Scott216/Hockey-Robot/Inverse Kinematics.xlsx

Sheet: Inverese Kinematics Calc
http://www.oliverjenkins.com/blog/2012/9/inverse-kinematics-and-robot-arms
http://www.learnaboutrobots.com/inverseKinematics.htm
https://www.circuitsathome.com/mcu/robotic-arm-inverse-kinematics-on-arduino
Github IK Discussion (https://github.com/phenoptix/MeArm/issues/3)
θ1 = ATan(y / x) + ACos( (L12 - L22 + X2 + Y2) / (2 * L1 * B) )
θ2 = π - ACos ( (B2 - L12 - L22) / (2 * L1 * L2) )
L1 | L2 | X | Y | B | θ1 | θ2
9.0 | 7.0 | 7.0 | 9.0 | 11.4 | 90.0 | 90.0
9.0 | 7.0 | 16.0 | 0.0 | 16.0 | 0.0 | 0.0
9.0 | 7.0 | 11.3 | 11.3 | 16.0 | 45.0 | 0.01527808827
140.0 | 153.0 | 242.0 | 150.0 | 284.7 | 46.1 | 27.3
Sain Smart 4dof Arm (http://www.sainsmart.com/diy-4-axis-servos-control-palletizing-robot-arm-model-for-arduino-uno-mega2560.html)
Z should always be on hockey table.
L1 | L2 | Y | Z | B | θ1 | θ2 | Chart Data
140.0 | 153.0 | 250.0 | 10.0 | 250.2 | 35.2 | 117.2 | Y | Z
 |  |  |  |  |  |  | 0.0 | 0.0
 |  |  |  |  |  |  | 114.4 | 80.8
 |  |  |  |  |  |  | 250.0 | 10.0
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
