Scott216/Hockey-Robot/Arm Angles.jpg

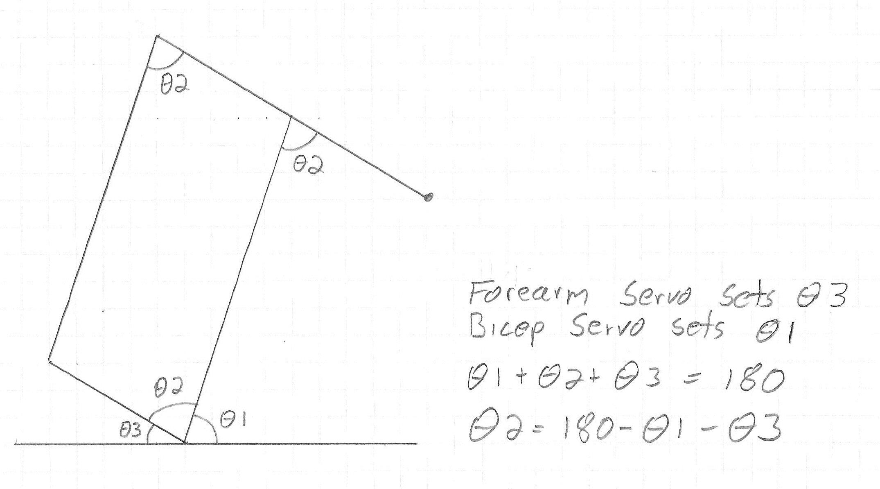
Arm Angles.jpg
