Scott216/Hockey-Robot/Design Files/Cutlist.png

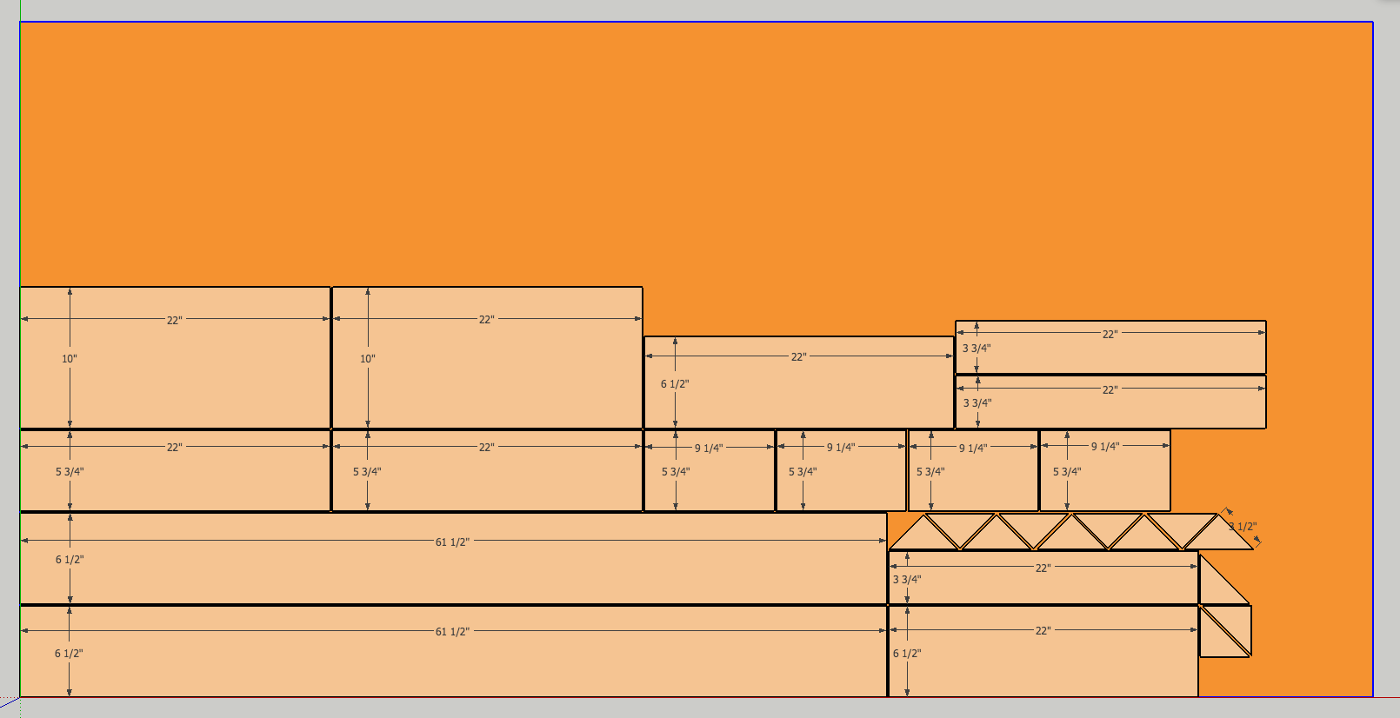
Design Files/Cutlist.png
