Scott216/Hockey-Robot/Design Files/Hockey Table Schematic.png

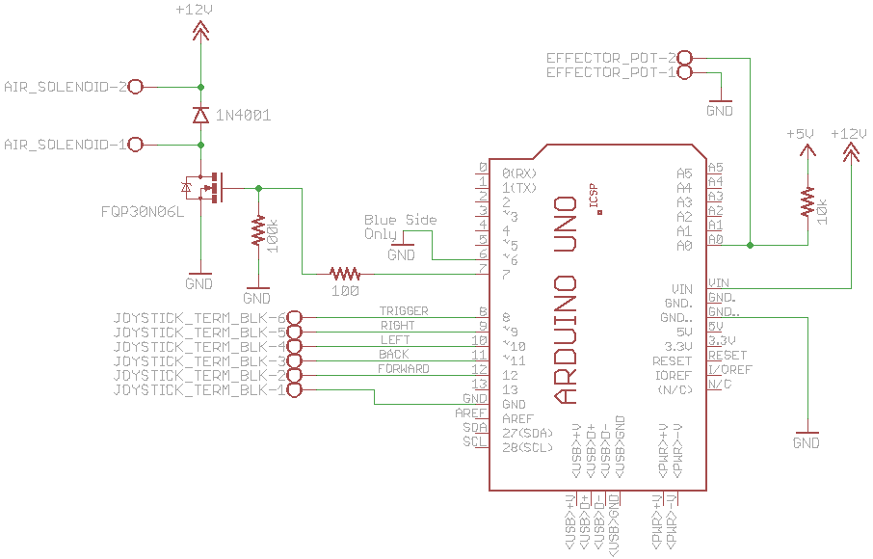
Design Files/Hockey Table Schematic.png
