Scott216/Hockey-Robot/Design Files/BoM.xlsx

Qty | Description | Source | Part Num | Price (each) | Comments
1 | 3/4" Sheet plywood, Grade A | Lumber Yard |  | $60.00
1 | 1/4" Sheet tempered Masonite | Lumber Yard |  | $22.00
2 | Arduino Uno R3 | Sparkfun | DEV-11021 | $25.00 | Can get clones a lot cheaper
2 | Servo board I2C | Adafruit | 1411 | $17.50
2 | Arcade Joystick | Sparkfun | COM-09136 | $20.00
2 | N-channel MOSFETs, FQP30N06L | Sparkfun | COM-10213 | $0.95 | Turns on air solenoid
2 | 100k 1/8 watt resistor | Digikey | CF18JT100KCT-ND | $0.10
2 | 100 ohm 1/8 watt restors | Digikey | CF18JT100RCT-ND | $0.10
2 | 1N4001 Diode | Digikey | 1N4001-TPMSCT-ND | $0.10
4 | 2-position terminal block | Digikey | A98333-ND | $0.87
2 | 4-position terminal block | Digikey | A98335-ND | $2.24
2 | DIN Plug | Digikey | CP-1030-ND | $1.66
2 | DIN Receptacle, panel mount | Digikey | CP-1230-ND | $2.31
2 | 10k Potientometer | Amazon | a13060500ux0042 | $0.65
2 | Knobs for Potientometer | Amazon | a13041000ux0023 | $0.52
10 | Terminal connectors | McMaster | 7243K112 | $0.43
2 | 4-axis Robotic Arms | SainSmart | 20-014-303 | $118.00 | SCARA style arm would be better
8 | Servo extension cables | Amazon |  | $1.00
2 | Air Soleniod valves, 12 volt | McMaster | 61975K41 | $29.40 | Can get cheaper on Ebay
1 | Air Regulator, 2-125 PSI | McMaster | 41735K11 | $30.25 | Can get cheaper on Amazon
1 | Mounting Bracket for Air regulator | McMaster | 41735K48 | $9.71
1 | Pressure Gauge 0-100 PSI | Ebay |  | $10.00
8 | 10-32 x 7/8" Socket Head Cap Screws | McMaster | 91251A346 | $0.12 | To mount joystick
8 | 10-32 Flange Nuts | McMaster | 94831A611 | $0.04 | To mount joystick
8 | 1/4-20 x 3" studs | McMaster | 91565A554 | $0.28 | Studs for joystick mount Can buy 3" bolts and cut of head.
8 | #6 x 1/2" pan head sheet metal screw | McMaster | 90190A148 | $0.03 | Mount robot arm
16 | #6 x 3/8" pan head sheet metal screws | McMaster | 90190A146 | $0.02
3 | Aluminum angle brackets | McMaster | 1556A24 | $0.43 | To hold joystick platform and power supply
6 | #10 x 3/8 pan head sheet metal screw | McMaster | 90190A240 | $0.06 | for angle bracket
4 | M4x5 machine screws | McMaster | 91239A136 | $0.12 | Mount air solenoid to bracket
1 | 1-1/4" aluminum angle | McMaster | 8982K11 | $3.90 | To hold air solenoid, need to cut
1 | Power supply, 190 watt | Compaq | 173828-001 | $20.00 | Need 5v and 12v. From a 1U server. Avail on ebay
1 | Computer power cord | Junk Drawer |  | $0.00 | For power supply
2 | 3D printed Arduino mounts |  |  | $1.78
2 | 3D printed joystick mounts |  |  | $13.62 | Use 50% infill so it's strong
2 | 3D printed ball scoops on effector |  |  | $0.77
6 | M3 Heat-set Threaded Inserts | McMaster | 94180A333 | $0.15 | Mount Arduino Uno, screw can only fit in 3 of the 4 holes
6 | M3 x 6 socket head cap screws | McMaster | 91290A111 | $0.08 | Mount Arduino Uno, screw can only fit in 3 of the 4 holes
4 | M3 x 8 Socket head cap screws | McMaster | 94500A222 | $0.06 | Mount DIN receptacle
4 | M3 Nuts | McMaster | 90592A009 | $0.01 | Mount DIN receptacle
1 | 1/8" Clear Acrylic | McMaster | 8589K42 | $9.82 | For Logo
1 | 1/8" Black Acrylic | McMaster | 8505K11 | $6.74 | For Lettering
2 | Brass Barbed Hose Fitting, Adapter for 1/8" Hose ID X 1/4" NPTF | McMaster | 5346K62 | $1.19
1 | Air hose quick disconnect coupling | McMaster | 6536K18 | $5.63
2 | 1/4" Push to connect x 1/4" Male NPT hose coupling, 90 degree | McMaster | 5779K152 | $3.42
1 | 1/4" Push to connect x 1/4" male NPT hose coupling | McMaster | 5779K109 | $3.08
1 | Push to connect Tee | McMaster | 5779K34 | $4.75
10 | 1/4" Tubing, push to connect | McMaster | 5180K71 | $0.10 | From regulator to solenoids
5 | 1/4" OD, 1/8" ID flexible tubing | McMaster | 51075K22 | $0.79 | Air line from effector to solenoid
2 | Hose Clamps | McMaster | 5388K14 | $0.59
12 | Small Ty-raps | McMaster | 7130K52 | $0.02
1 | Pack 3/8" x 2" wood dowel pegs | McMaster | 97195A434 | $4.67
4 | 1/4" Plastic Loop Clamps | McMaster | 8876T13 | $0.05 | Holding wiring and tubing
4 | 3/8" Plastic Loop Clamps | McMaster | 8876T22 | $0.06 | Holding wiring
2 | 22 AWG Solid wire, various colors | McMaster | 8073K62 | $0.10 | Wiring on Servo board
20 | 22 AWG Stranded wire, various colors | McMaster | 7587K52 | $0.11 | Wiring from joystick and potientometer to Arduino
10 | 3-conductor standed cable | McMaster | 6452T41 | $0.62 | For power to arduino
1 | 6- position Connector Barrier Block Strip | Digikey | A98507-ND | $2.85 | For power supply
1 | Heat shrink tubing | McMaster | 7856K63 | $0.80 | For DIN receptacle
6 | Spade terminals | McMaster | 69145K212 | $0.15 | Power supply to terminal connector
1 | Pack ping pong balls |  |  | $3.00
1 | Compressor |  |  | $60.00
 | Grand Total |  |  | $775.88
