Scott216/Hockey-Robot/Design Files/Uno Mount.stl

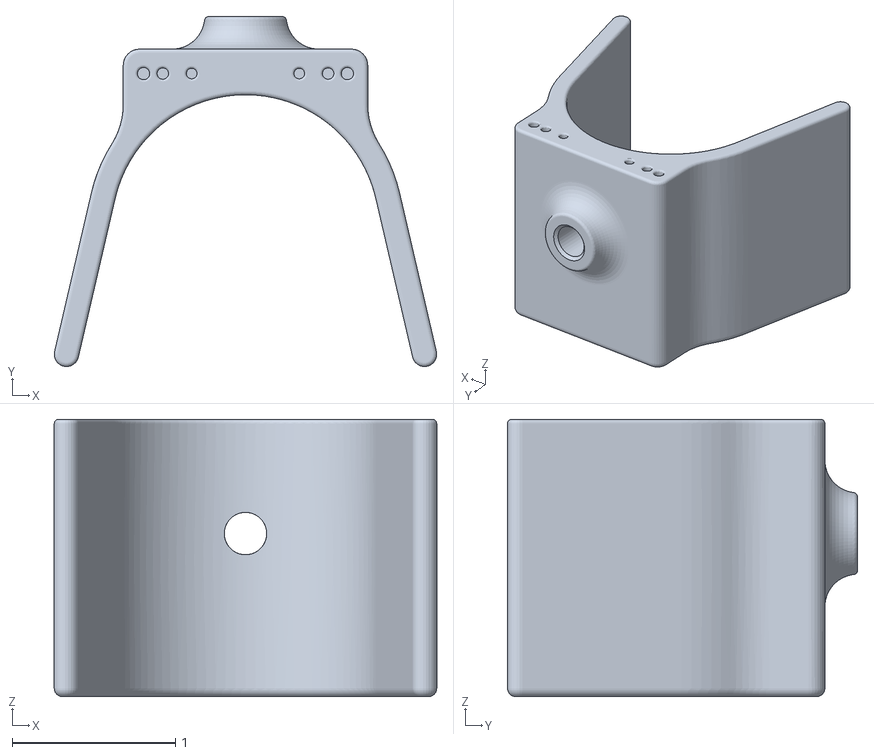
[picture p4: CAD file, 2015-10-01]
Design Files/Uno Mount.stl
2.35 x 2.15 x 1.70
