Scott216/Hockey-Robot/Design Files/Joystick Mount.stl

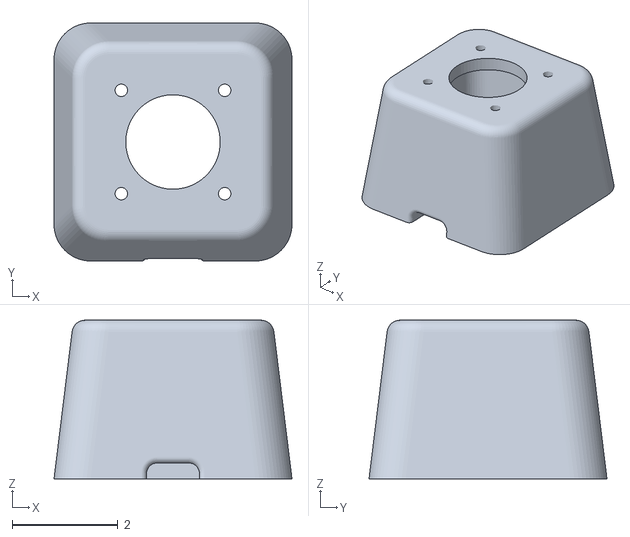
[picture p5: CAD file, 2015-10-01]
Design Files/Joystick Mount.stl
4.50 x 4.50 x 3.00
