Scott216/Hockey-Robot/(list of files, cad)

Other CAD files:
Design Files/Effectror.stl
Design Files/Hockey Table.f3d
Design Files/Plywood Cut List.skp
Design Files/Plywood Cut List~.skp
