Scott216/Hockey-Robot/Design Files/Hockey Table.sch

## EAGLE design Design Files/Hockey Table.sch (2015-10-01)

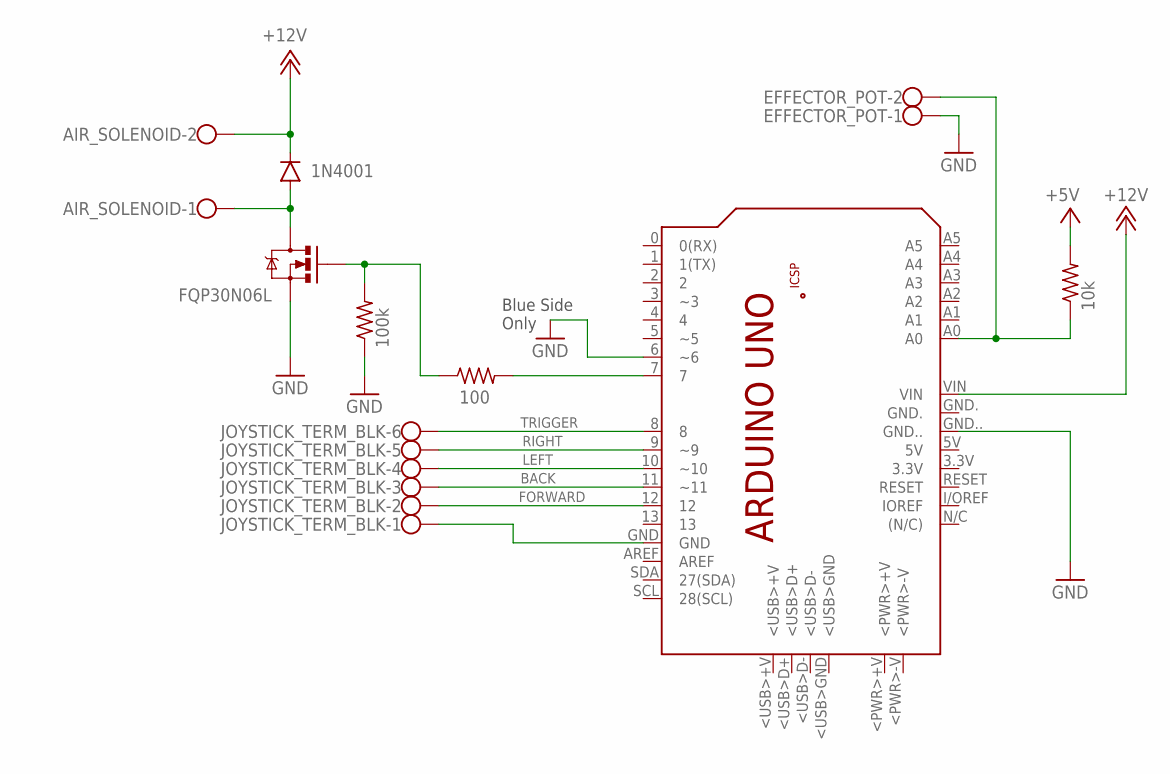
[picture p6: schematic Hockey Table.sch]

Parts:
AIR_SOLENOID: TERMBLK_SCREW_2RIGHT; TERMBLK_SCREW_2
D1: 1N4001; DIODE-1N4148
EFFECTOR_POT: TERMBLK_SCREW_2RIGHT; TERMBLK_SCREW_2
JOYSTICK_TERM_BLK: TERMBLK_SCREW_6RIGHT; TERMBLK_SCREW_6
PCB1: ARDUINO_UNO
Q1: FQP30N06L; TO220V
R1: 10k; 0207/10
R2: 100k; 0207/10
R3: 100; 0207/10

Connections:
+5V: R1.2
+12V: AIR_SOLENOID.2, D1.C, PCB1.VIN
BACK: JOYSTICK_TERM_BLK.3, PCB1.11 (~11)
FORWARD: JOYSTICK_TERM_BLK.2, PCB1.12
GND: EFFECTOR_POT.1, PCB1.6 (~6), PCB1.GND.., Q1.3 (S), R2.1
LEFT: JOYSTICK_TERM_BLK.4, PCB1.10 (~10)
unnamed: JOYSTICK_TERM_BLK.1, PCB1.GND
unnamed: EFFECTOR_POT.2, PCB1.A0, R1.1
unnamed: AIR_SOLENOID.1, D1.A, Q1.2 (D)
unnamed: Q1.1 (G), R2.2, R3.1
unnamed: PCB1.7, R3.2
RIGHT: JOYSTICK_TERM_BLK.5, PCB1.9 (~9)
TRIGGER: JOYSTICK_TERM_BLK.6, PCB1.8

Notes on the sheet:
Blue Side Only
