Scott216/Hockey-Robot/(commit log)

2015-09-16 v1.03 - IK working
    [Inverse Kinematics.xlsx]
2015-09-17 Updated spreadsheet
    [Inverse Kinematics.xlsx]
2015-09-27 No Change
    [Inverse Kinematics.xlsx]
2015-10-01 Design Files
    [BoM.xlsx, Effectror.stl, Hockey Table.f3d, Hockey Table.sch, Joystick Mount.stl, Plywood Cut List.skp, Plywood Cut List~.skp, Uno Mount.stl]
